makmorit/NixieTube/FourDigitDisplay/pwr_supply_board.brd.pdf

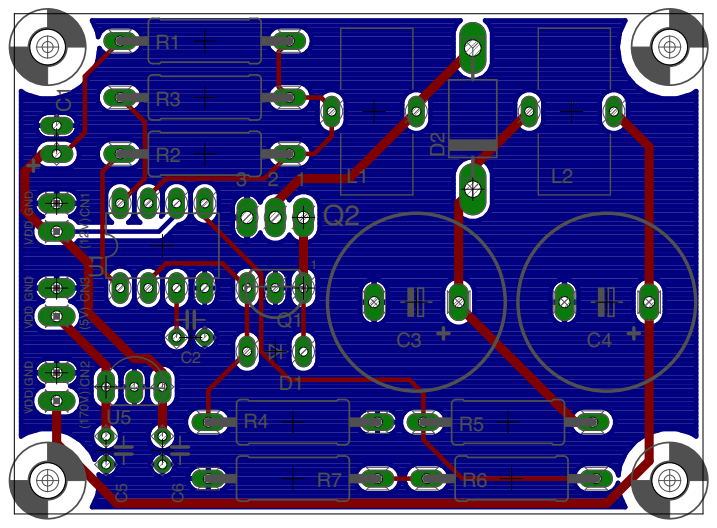
[picture p1: page 1]

(5V) (12V) (170V) VDD GND VDD GND VDD GND 1 3 2 1 C1 C2 C3 C4 C5 C6 CN1 CN2 CN3 D1 D2 L1 L2 Q1 Q2 R1 R2 R3 R4 R5 R7 R6 U1 U5
