makmorit/NixieTube/FourDigitDisplay/pwr_supply_board.pdf

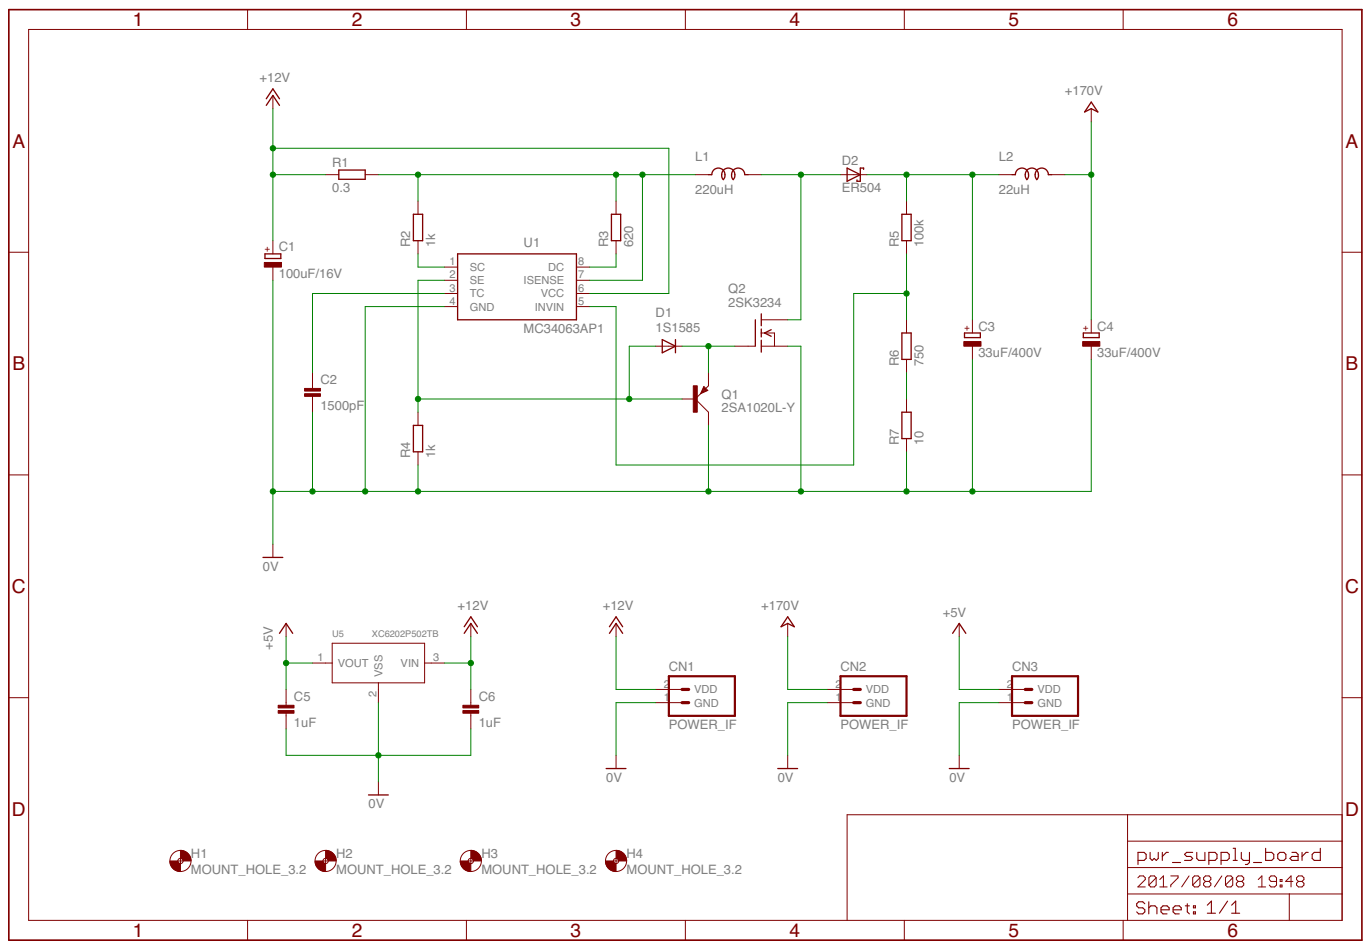
[picture p2: page 1]
