makmorit/NixieTube/ThreeDigitDisplay/ThreeDigitDisplay.pdf

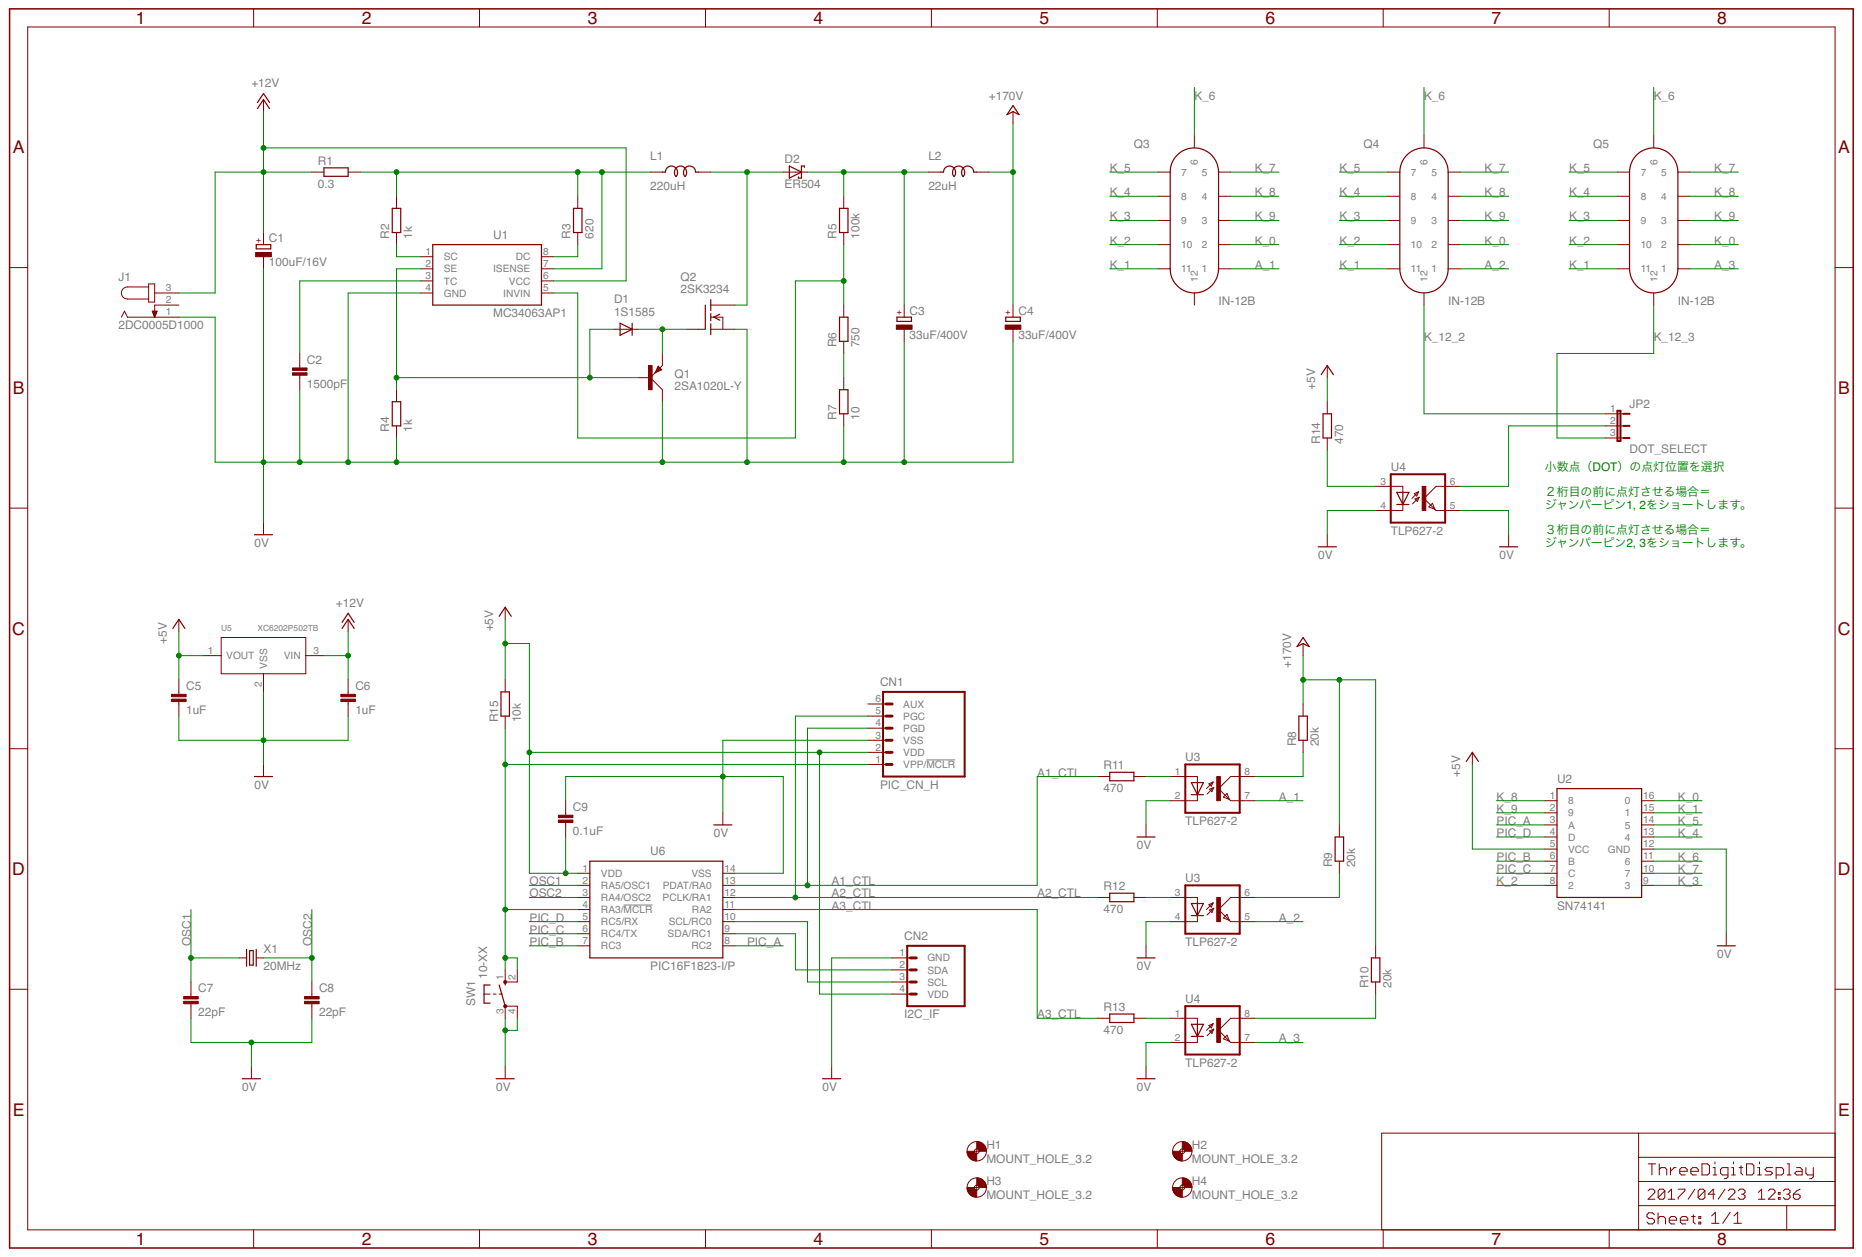
[picture p3: page 1]
