makmorit/NixieTube/FourDigitDisplay/pwr_supply_board.brd

## EAGLE design FourDigitDisplay/pwr_supply_board.brd (2017-09-15)

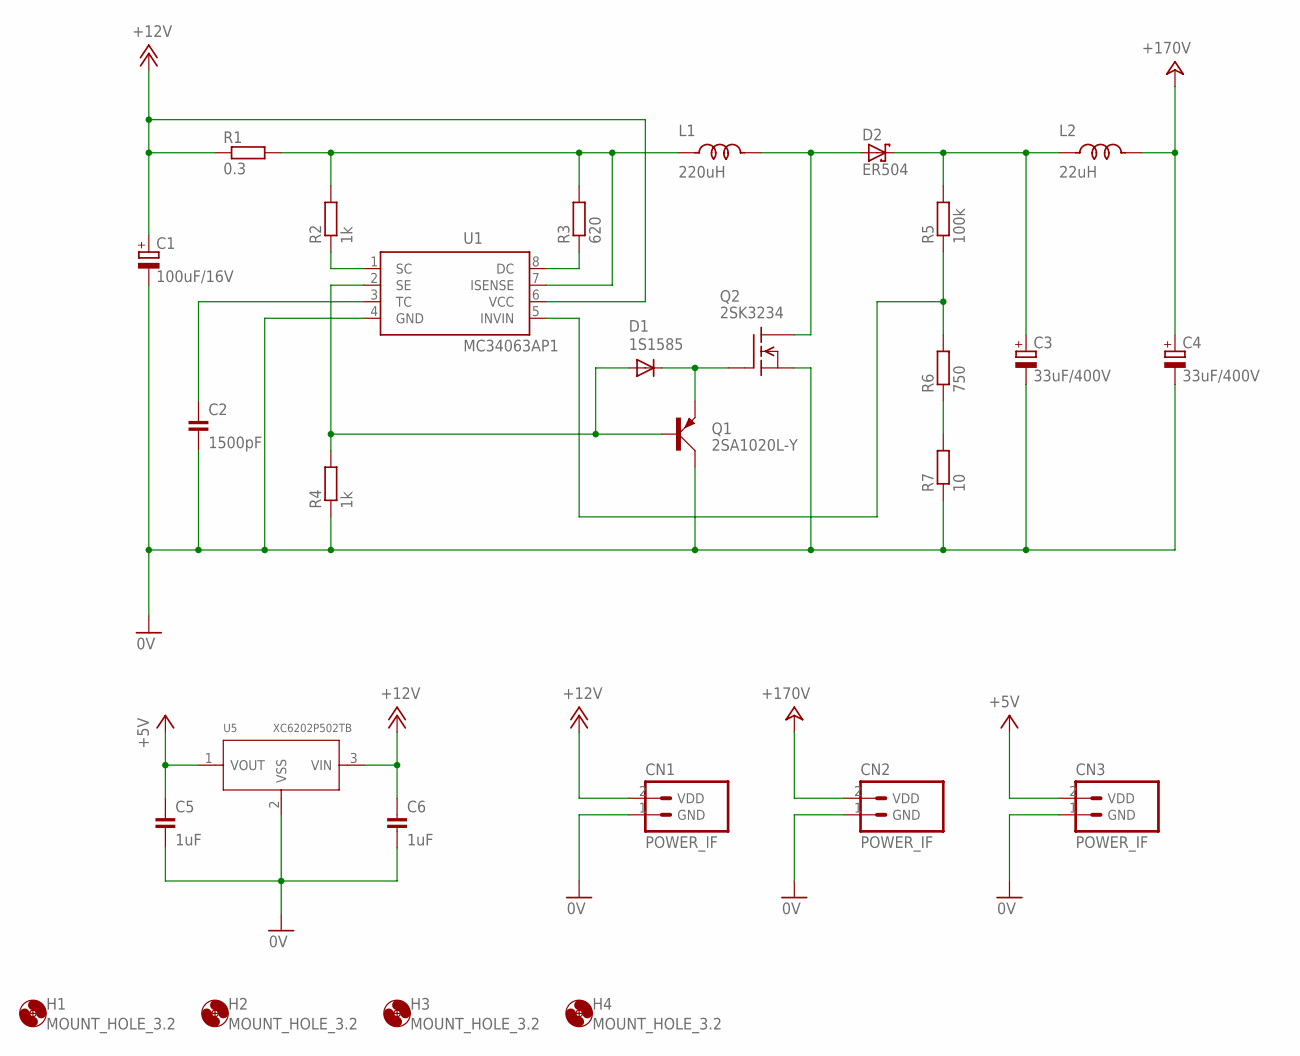
[picture p4: schematic pwr_supply_board.sch]

Parts:
C1: 100uF/16V; ELECAP_100MIL
C2: 1500pF; CAP_100MIL
C3, C4: 33uF/400V; ELECAP_300MIL
C5, C6: 1uF; CAP_100MIL
CN1, CN2, CN3: POWER_IF; HEADER_2PIN_POWER_IF
D1: 1S1585; DIODE-200MIL
D2: ER504; DIODE-500MIL
H1, H2, H3, H4: MOUNT_HOLE_3.2; 3,2
L1: 220uH; TOROID_COIL-300MIL
L2: 22uH; TOROID_COIL-300MIL
Q1: 2SA1020L-Y; TO-92NL
Q2: 2SK3234; TO-220
R1: 0.3; RESISTOR_0411_600MIL
R2, R4: 1k; RESISTOR_0411_600MIL
R3: 620; RESISTOR_0411_600MIL
R5: 100k; RESISTOR_0411_600MIL
R6: 750; RESISTOR_0411_600MIL
R7: 10; RESISTOR_0411_600MIL
U1: MC34063AP1; DIL08
U5: XC6202P502TB; TO92-LINE

Connections:
0V: C1.-, C2.2, C3.-, C4.-, C5.2, C6.2, CN1.1 (GND), CN2.1 (GND), CN3.1 (GND), Q1.2 (C), Q2.3 (S), R4.1, R7.1, U1.4 (GND), U5.2 (VSS)
+5V: C5.1, CN3.2 (VDD), U5.1 (VOUT)
+12V: C1.+, C6.1, CN1.2 (VDD), R1.1, U1.6 (VCC), U5.3 (VIN)
+24V: C4.+, CN2.2 (VDD), L2.2
unnamed: R3.1, U1.8 (DC)
unnamed: C3.+, D2.C, L2.1, R5.2
unnamed: C2.1, U1.3 (TC)
unnamed: R2.1, U1.1 (SC)
unnamed: L1.1, R1.2, R2.2, R3.2, U1.7 (ISENSE)
unnamed: R5.1, R6.2, U1.5 (INVIN)
unnamed: D1.A, Q1.3 (B), R4.2, U1.2 (SE)
unnamed: D1.C, Q1.1 (E), Q2.1 (G)
unnamed: R6.1, R7.2
unnamed: D2.A, L1.2, Q2.2 (D)

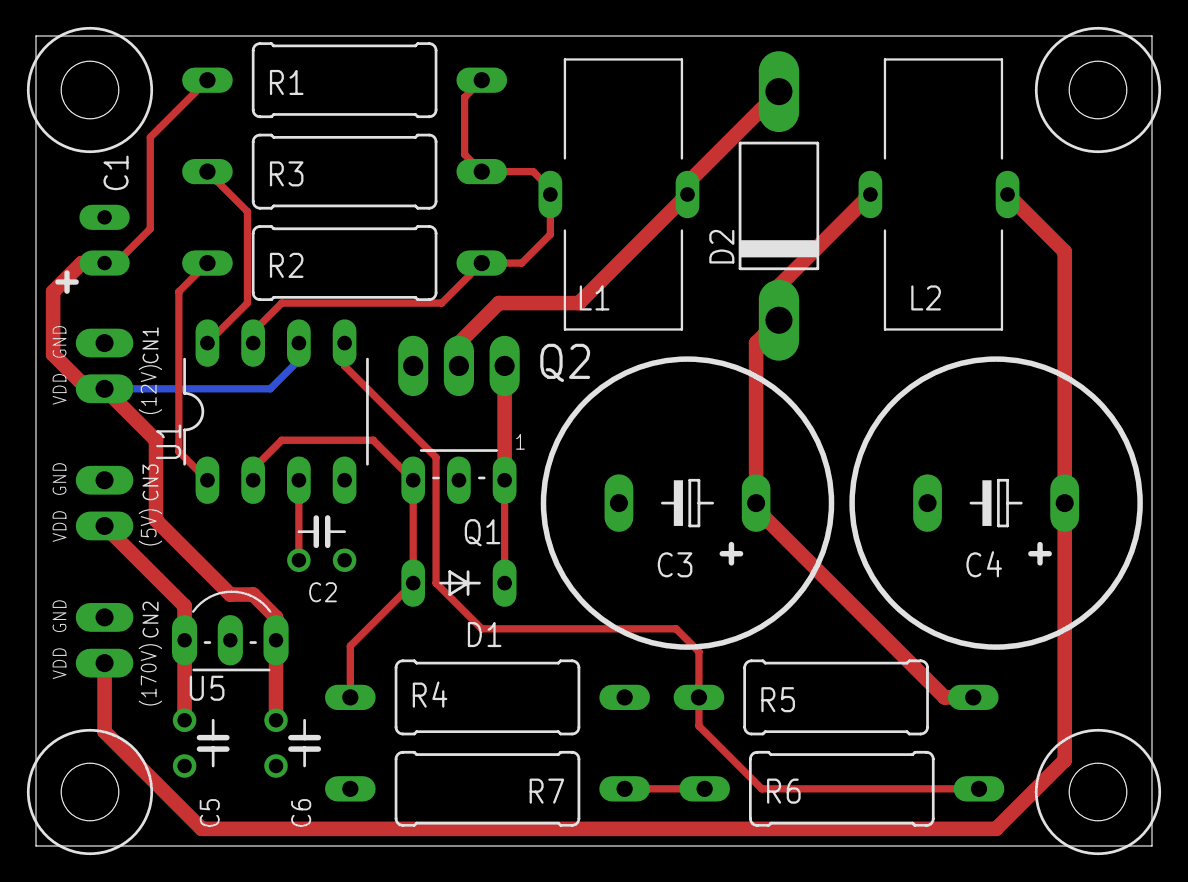
[picture p5: board pwr_supply_board.brd from above]

Board: 2 copper layers, 62.0 x 45.0 mm, 28 parts (0 on the bottom side), 14 nets.
