makmorit/NixieTube/(commit log)

2017-03-10 ライブラリーを大幅修正
2017-03-11 ライブラリーを小修正
2017-03-11 170V電源回路図の初版
    [PowerBoard.sch]
2017-03-11 170V出力をターミナルブロックに変更
    [PowerBoard.sch]
2017-03-11 データシートを格納
2017-03-15 実体配線図の初版
    [PowerBoard.brd, PowerBoard.sch]
2017-03-15 ignoreリスト更新
2017-03-18 IC（２件）をライブラリーに追加
    SN74141
    PIC16F1823
2017-03-18 IC（１件）をライブラリーに追加
    TLP627
2017-03-20 部品（１件）をライブラリーに追加
    ニキシー管の初版（細かいところは後日修正予定）
2017-03-22 点灯制御の回路図初版
    足りない部品も追加
    [ControlBoard.sch]
2017-03-23 点灯制御の回路図を修正
    PICのVDDが5Vにつながっていなかったので修正
    [ControlBoard.sch]
2017-03-24 デバッグ用ファームウェアの初版
    Shift_JIS なのでコメントが化けてます
2017-03-25 デバッグ用ファームウェア修正
    以下の仮実装を追加
    ・ダイナミック点灯用の制御（２けた分）切替は10msごと
    ・タクトスイッチを押すと１００秒間カウントダウン
    [main.c, process.c, process.h]
2017-04-01 ダイナミック点灯のロジックを修正
    ダイナミック点灯間隔（9msec）のうち、
    ・最初の3msecはアノードをOffとする
    ・次の6msecはアノードをOnとする
    よう修正しました。
    [main.c, process.c, process.h]
2017-04-02 ３桁表示（M.SS形式）対応
    ・コメントをShift_JISからUTF-8へ変更
    ・カウンター残秒数を３桁（M.SS形式）で表示できるよう修正
    ・３分間（１８０秒間）のカウンターに変更（表示が3.00-->2.59-->...-->0.01-->0.00）と変わるようになります
    [device.c, main.c, process.c, process.h]
2017-04-02 ダイナミック点灯のロジックを修正
    ・最初の0.8msecはアノードをOffとする
    ・次の3.2msecはアノードをOnとする
    この対応によりニキシー点灯時の「ちらつき」が若干解消しました。
    ついでに、不要となった処理／変数を削除しています。
    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
    [main.c, process.c, process.h]
2017-04-04 ３桁表示用基板の回路図の初版
    部品を１点追加しています
    [DigitDisplayBoard.sch]
2017-04-04 ３桁表示用基板の使用部品を修正
    ライブラリーを修正（抵抗器）
    基板で使用する部品の見直し
    [DigitDisplayBoard.brd, DigitDisplayBoard.sch]
2017-04-23 回路図を修正
    ・I2Cインターフェースを新設
    ・小数点(DOT)の表示位置変更（または非表示）を可能とする
    [ThreeDigitDisplay.sch]
2017-04-23 PICファームウェアをMPLAB X IDE用に再編成
2017-04-23 不要リソースを削除
    [ControlBoard.sch, DigitDisplayBoard.brd, DigitDisplayBoard.sch, PowerBoard.brd, PowerBoard.sch]
2017-04-23 コメントを修正
2017-04-23 ignore追加
2017-04-30 ignore更新
2017-04-30 不要ファイルの削除
2017-08-07 ４桁表示器の初版
    回路図はまだ空です。
    [nixie_ctrl_board.sch, pwr_supply_board.sch]
2017-08-08 電源回路図の初版
    12Vから170V、5Vの２電源を生成し出力させる回路
    [pwr_supply_board.sch]
2017-08-08 マウントホール追加
    [pwr_supply_board.sch]
2017-08-08 部品配置
    [pwr_supply_board.brd, pwr_supply_board.sch]
2017-08-09 制御基板の初版
    まだニキシー管を配置しただけ
    [nixie_ctrl_board.brd, nixie_ctrl_board.sch]
2017-08-10 IC群を追加して仮置き
    [nixie_ctrl_board.brd, nixie_ctrl_board.sch]
2017-08-11 配線の追加
    [nixie_ctrl_board.brd, nixie_ctrl_board.sch]
2017-08-13 部品配置修正
    [nixie_ctrl_board.brd, nixie_ctrl_board.sch]
2017-08-15 電源基板の部品配線
    [pwr_supply_board.brd, pwr_supply_board.sch]
2017-08-17 配線を一部修正
    [pwr_supply_board.brd]
2017-09-15 制御ボードの開発を中止
    [nixie_ctrl_board.brd, nixie_ctrl_board.sch]
2017-09-15 電源回路の部品配置を確定
